lo0pin/SailSense/3d_models/sailsense.3mf

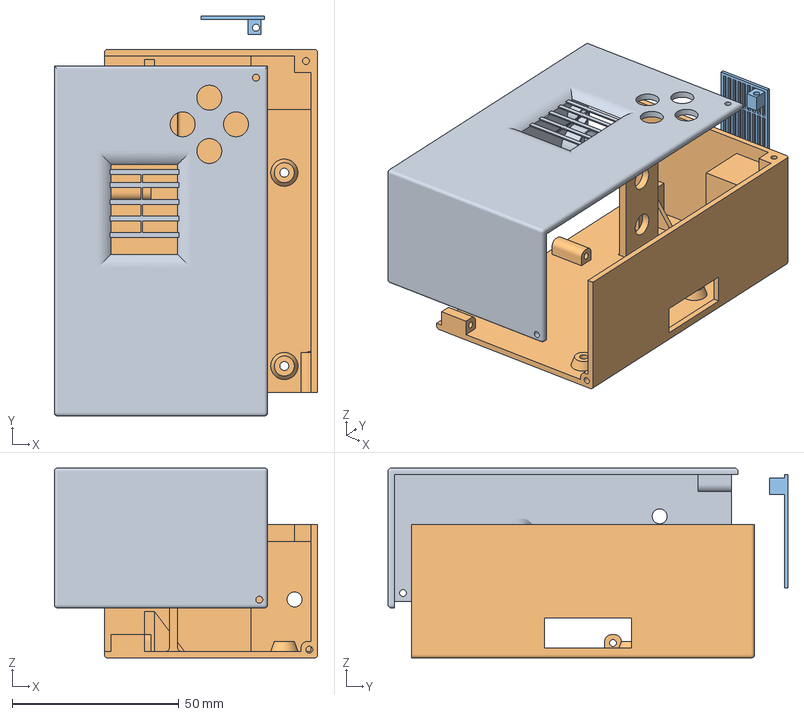
[picture p1: CAD file, 2026-11-01]
3d_models/sailsense.3mf
79.0 x 120.0 x 57.0 mm
Körper1
Körper25
gitter
