lo0pin/SailSense/(list of files, cad)

Other CAD files:
3d_models/sailsense.f3d
