lo0pin/SailSense/src/sailsense/gps/gps_reader.py

from datetime import datetime, timezone
from typing import Iterator, Optional

import serial
import pynmea2


class GPSReader:
    """
    Liest NMEA-Daten von einem GPS/GNSS-Empfänger.

    read_point():
        liest eine NMEA-Zeile und liefert ggf. einen GPS-Datensatz.

    read_points():
        Generator für alte Tests/Logger.
    """

    def __init__(self, port: str, baudrate: int = 9600, timeout: float = 1.0):
        self.port = port
        self.baudrate = baudrate
        self.timeout = timeout
        self.serial_connection = None

        self.latest_gga = {
            "alt_m": None,
            "sats": None,
            "fix_quality": None,
            "hdop": None,
        }

    def __enter__(self):
        self.serial_connection = serial.Serial(
            self.port,
            self.baudrate,
            timeout=self.timeout,
        )
        return self

    def __exit__(self, exc_type, exc_value, traceback):
        if self.serial_connection and self.serial_connection.is_open:
            self.serial_connection.close()

    @staticmethod
    def _to_float(value) -> Optional[float]:
        if value in (None, ""):
            return None
        try:
            return float(value)
        except (TypeError, ValueError):
            return None

    @staticmethod
    def _timestamp_from_rmc(msg) -> str:
        try:
            dt = datetime.combine(msg.datestamp, msg.timestamp)
            return dt.replace(tzinfo=timezone.utc).isoformat().replace("+00:00", "Z")
        except Exception:
            return datetime.now(timezone.utc).isoformat().replace("+00:00", "Z")

    def read_point(self) -> Optional[dict]:
        """
        Liest eine NMEA-Zeile.
        Gibt nur bei gültigem RMC-Satz einen GPS-Punkt zurück.
        Sonst None.
        """
        if self.serial_connection is None:
            raise RuntimeError("GPSReader muss mit 'with GPSReader(...) as gps:' verwendet werden.")

        raw = self.serial_connection.readline().decode("ascii", errors="replace").strip()

        if not raw:
            return None

        try:
            msg = pynmea2.parse(raw)
        except pynmea2.ParseError:
            return None

        if msg.sentence_type == "GGA":
            self.latest_gga["alt_m"] = self._to_float(getattr(msg, "altitude", None))
            self.latest_gga["sats"] = getattr(msg, "num_sats", None)
            self.latest_gga["fix_quality"] = getattr(msg, "gps_qual", None)
            self.latest_gga["hdop"] = self._to_float(getattr(msg, "horizontal_dil", None))
            return None

        if msg.sentence_type == "RMC":
            status = getattr(msg, "status", None)

            if status != "A":
                return None

            speed_kn = self._to_float(getattr(msg, "spd_over_grnd", None))
            speed_kmh = speed_kn * 1.852 if speed_kn is not None else None

            return {
                "timestamp_utc": self._timestamp_from_rmc(msg),
                "lat": getattr(msg, "latitude", None),
                "lon": getattr(msg, "longitude", None),
                "speed_kn": speed_kn,
                "speed_kmh": speed_kmh,
                "course_deg": self._to_float(getattr(msg, "true_course", None)),
                "alt_m": self.latest_gga["alt_m"],
                "sats": self.latest_gga["sats"],
                "fix_quality": self.latest_gga["fix_quality"],
                "hdop": self.latest_gga["hdop"],
            }

        return None

    def read_points(self) -> Iterator[dict]:
        while True:
            point = self.read_point()
            if point is not None:
                yield point
