lo0pin/SailSense/(commit log)

2026-11-01 src/sailsense/system/__init__.py src/sailsense/system/power.py src/sailsense/system/__pycache__/__init__.cpython-313.pyc src/sailsense/system/__pycache__/power.cpython-313.pyc
2026-11-01 imu deleted
2026-11-01 imu new
